korneliuszo/picopocket-hw/(threads)

Thread 2 (2025-04-10):

Want to buy picopocket-hw (makers needed)

korneliuszo, 2025-04-10:
> Thanks @HeathenUK!
>
> Btw, do you have any plans to sell assembled units?

 _Originally posted by @rafael2k in [#1](https://github.com/korneliuszo/picopocket-hw/issues/1#issuecomment-2793152441)_

Sorry, I don't have means to produce this project.

If somebody is interested in setting up production I can send working prototype to help setting up QA station and work out manufacturing problems

rafael2k, 2025-04-11:
Thanks for the answer and availability to support production!
