korneliuszo/picopocket-hw/companionboard/companion_board.kicad_pcb

## KiCad design companionboard/companion_board.kicad_pcb (2025-04-15)

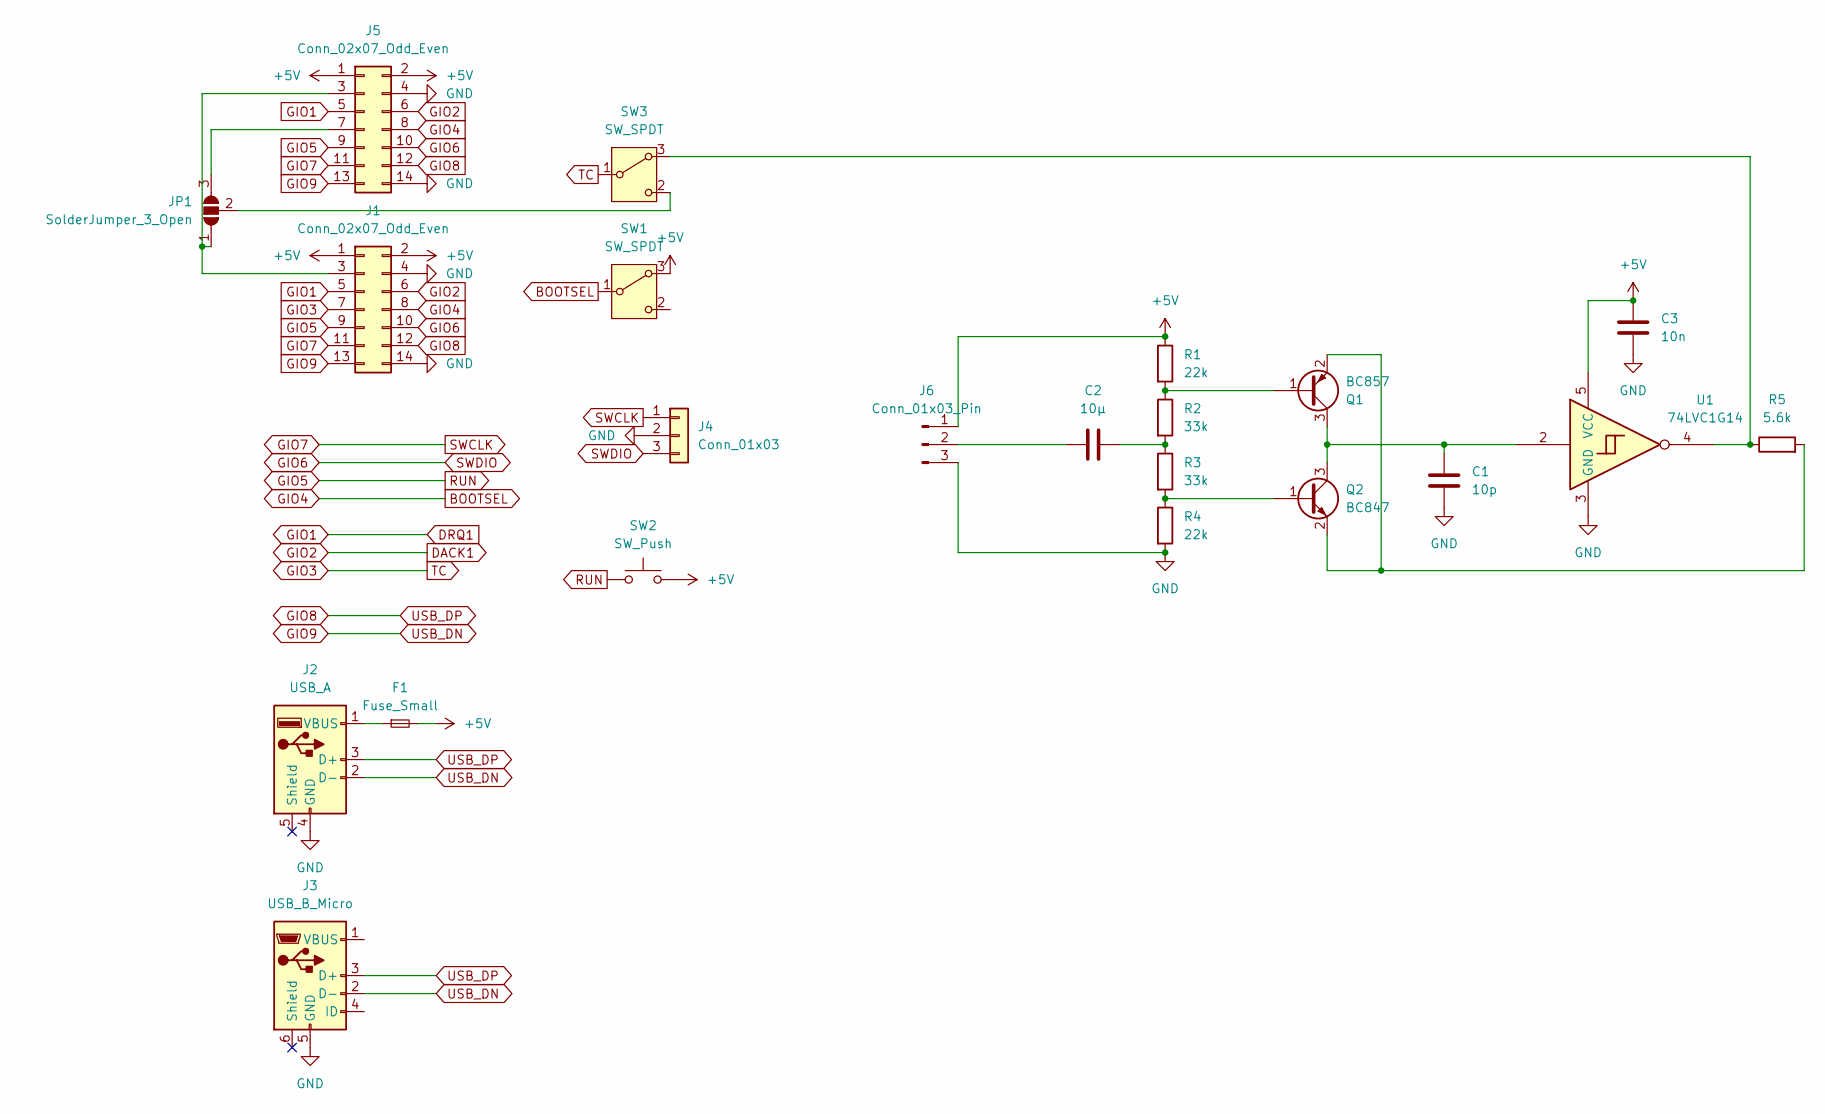
[picture p1: schematic companion_board.kicad_sch]

Parts:
C1: 10p; C_0805_2012Metric
C2: 10µ; C_0805_2012Metric
C3: 10n; C_0805_2012Metric
F1: Fuse_Small; Fuse_0805_2012Metric
J1: Conn_02x07_Odd_Even; EDGE-14
J2: USB_A; USB_A_CONNFLY_DS1095-WNR0
J3: USB_B_Micro; USB_Micro-B_Wuerth_614105150721_Vertical
J4: Conn_01x03; PinHeader_1x03_P2.54mm_Vertical
J5: Conn_02x07_Odd_Even; PinSocket_2x07_P2.00mm_Vertical
J6: Conn_01x03_Pin; PinHeader_1x03_P2.54mm_Vertical
JP1: SolderJumper_3_Open; SolderJumper-3_P2.0mm_Open_TrianglePad1.0x1.5mm
Q1: BC857; SOT-23
Q2: BC847; SOT-23
R1, R4: 22k; R_0402_1005Metric_Pad0.72x0.64mm_HandSolder
R2, R3: 33k; R_0402_1005Metric_Pad0.72x0.64mm_HandSolder
R5: 5.6k; R_0402_1005Metric_Pad0.72x0.64mm_HandSolder
SW1, SW3: SW_SPDT; SW_Slide-03_Wuerth-WS-SLTV_10x2.5x6.4_P2.54mm
SW2: SW_Push; SW_PUSH_6mm
U1: 74LVC1G14; SOT-353_SC-70-5_Handsoldering

Connections:
+5V: C3.1, F1.2, J1.1, J1.2, J5.1, J5.2, J6.1, R1.1, SW1.3 (A), SW2.2, U1.5 (VCC)
BOOTSEL: J1.8, J5.8, SW1.1 (B)
DACK1: J1.6, J5.6
DRQ1: J1.5, J5.5
GIO3: J1.7, SW3.1 (B)
GIO5: J1.9, J5.9, SW2.1
GIO6: J1.10, J4.3, J5.10
GIO7: J1.11, J4.1, J5.11
GIO8: J1.12, J2.3 (D+), J3.3 (D+), J5.12
GIO9: J1.13, J2.2 (D-), J3.2 (D-), J5.13
GND: C1.2, C3.2, J1.4, J1.14, J2.4 (GND), J3.5 (GND), J4.2, J5.4, J5.14, J6.3, R4.2, U1.3 (GND)
unnamed: C2.2, R2.2, R3.1
unnamed: J1.3, J5.3, JP1.1 (A)
unnamed: F1.1, J2.1 (VBUS)
unnamed: J5.7, JP1.3 (B)
unnamed: C2.1, J6.2
unnamed: JP1.2 (C), SW3.2 (C)
unnamed: Q1.1 (B), R1.2, R2.1
unnamed: C1.1, Q1.3 (C), Q2.3 (C), U1.2
unnamed: Q1.2 (E), Q2.2 (E), R5.2
unnamed: Q2.1 (B), R3.2, R4.1
unnamed: R5.1, SW3.3 (A), U1.4

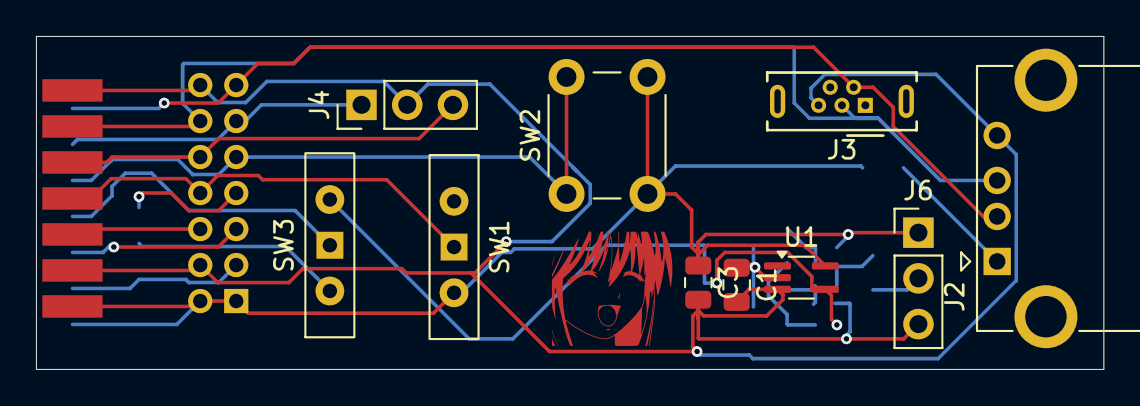
[picture p2: board companion_board.kicad_pcb from above]

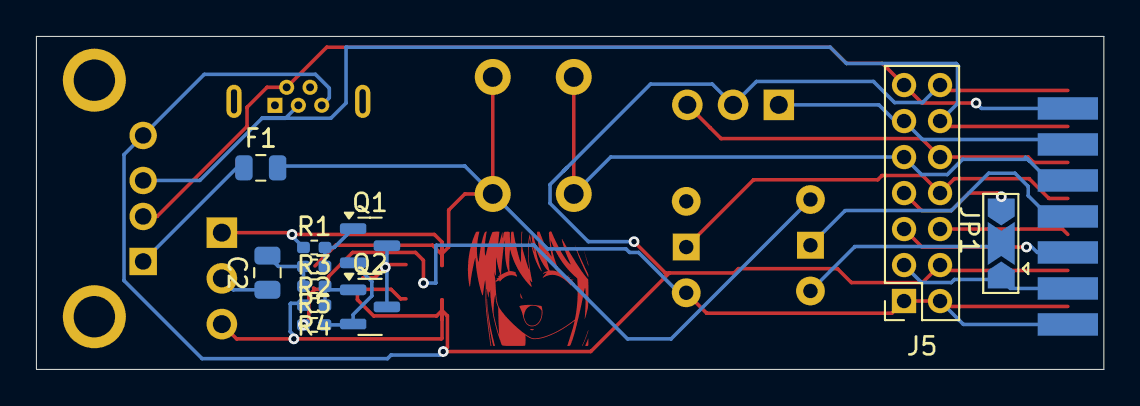
[picture p3: board companion_board.kicad_pcb from below]

Board: 2 copper layers, 59.3 x 18.5 mm, 22 parts (12 on the bottom side), 22 nets.
