korneliuszo/picopocket-hw/board/picopocket.kicad_pcb

## KiCad design board/picopocket.kicad_pcb (2024-04-07)

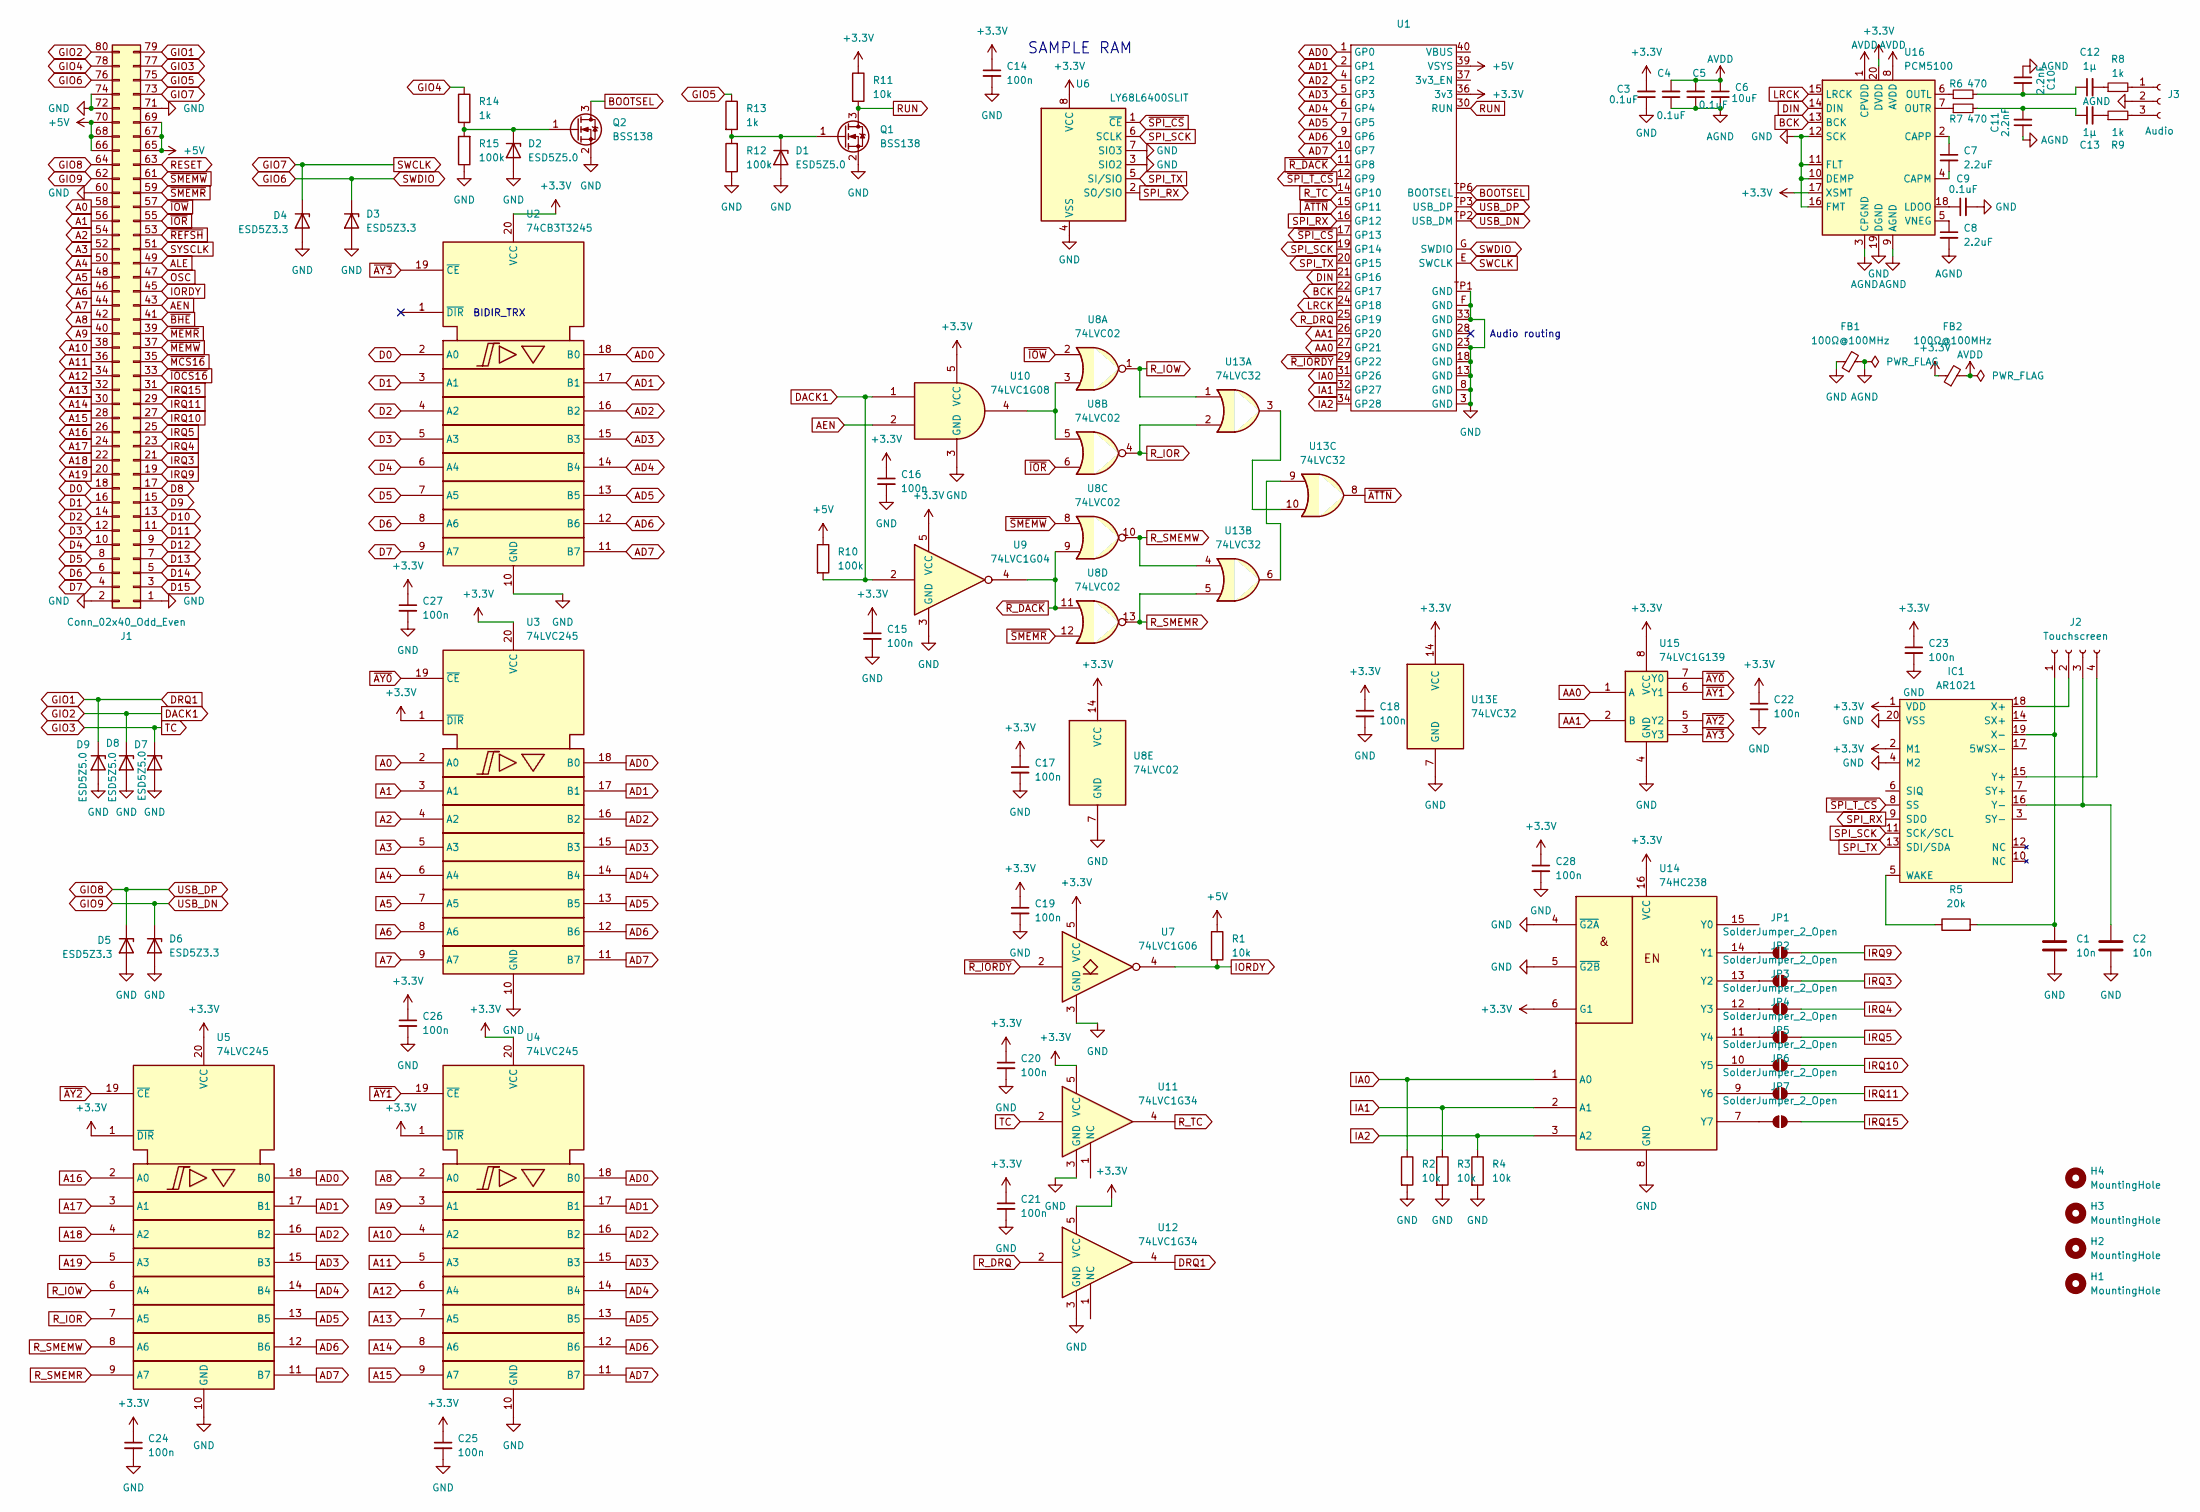
[picture p4: schematic picopocket.kicad_sch]

Parts:
C1, C2: 10n; C_0603_1608Metric; MPN C376807
C3, C4, C5, C9: 0.1uF; C_0402_1005Metric; MPN C361203
C6: 10uF; C_0805_2012Metric; MPN C1713
C7, C8: 2.2uF; C_0402_1005Metric; MPN C385032
C10, C11: 2.2nF; C_0603_1608Metric; MPN C107082
C12, C13: 1µ; C_1206_3216Metric; MPN C444884
C14, C15, C16, C17, C18, C19, C20, C21, C22, C23, C24, C25, C26, C27, C28: 100n; C_0201_0603Metric; MPN C5142565
D1, D2, D7, D8, D9: ESD5Z5.0; D_SOD-523; MPN C475685
D3, D4, D5, D6: ESD5Z3.3; D_SOD-523; MPN C475684
FB1, FB2: 100Ω@100MHz; L_0805_2012Metric; MPN C124102
H1, H2, H3, H4: MountingHole; MountingHole_2.7mm_M2.5_ISO14580_Pad
IC1: AR1021; SSOP-20_5.3x7.2mm_P0.65mm; MPN C220291; Farnell 2218568
J1: Conn_02x40_Odd_Even; XKB Male 80P 0.5P
J2: Touchscreen; Molex_PicoBlade_53261-0471_1x04-1MP_P1.25mm_Horizontal
J3: Audio; Molex_PicoBlade_53261-0371_1x03-1MP_P1.25mm_Horizontal
JP1, JP2, JP3, JP4, JP5, JP6, JP7: SolderJumper_2_Open; SolderJumper-2_P1.3mm_Open_TrianglePad1.0x1.5mm
Q1, Q2: BSS138; SOT-23; MPN C5337205
R1, R2, R3, R4, R11: 10k; R_0402_1005Metric; MPN C163811
R5: 20k; R_0402_1005Metric; MPN C3017501
R6, R7: 470; R_0402_1005Metric; MPN C3015779
R8, R9, R13, R14: 1k; R_0402_1005Metric; MPN C3152105
R10, R12, R15: 100k; R_0402_1005Metric; MPN C176119
U1: MODULE_SC0918
U2: 74CB3T3245; TSSOP-20_4.4x6.5mm_P0.65mm; MPN C1547227
U3, U4, U5: 74LVC245; TSSOP-20_4.4x6.5mm_P0.65mm; MPN C6082
U6: LY68L6400SLIT; SOIC-8_3.9x4.9mm_P1.27mm; MPN C261881
U7: 74LVC1G06; SOT-23-5; MPN C840103
U8: 74LVC02; TSSOP-14_4.4x5mm_P0.65mm; MPN C75069
U9: 74LVC1G04; SOT-23-5; MPN C460517
U10: 74LVC1G08; SOT-23-5; MPN C434068
U11, U12: 74LVC1G34; SOT-23-5; MPN C840096
U13: 74LVC32; TSSOP-14_4.4x5mm_P0.65mm; MPN C352974
U14: 74HC238; TSSOP-16_4.4x5mm_P0.65mm; MPN C60434
U15: 74LVC1G139; VSSOP-8_2.4x2.1mm_P0.5mm; MPN C153798
U16: PCM5100; TSSOP-20_4.4x6.5mm_P0.65mm; MPN C131154

Connections:
+3.3V: C3.2, C14.1, C15.1, C16.1, C17.1, C18.1, C19.1, C20.1, C21.1, C22.1, C23.1, C24.1, C25.1, C26.1, C27.1, C28.1, FB2.1, IC1.1 (VDD), IC1.2 (M1), R11.1, U1.36 (3v3), U2.20 (VCC), U3.1 (~DIR), U3.20 (VCC), U4.1 (~DIR), U4.20 (VCC), U5.1 (~DIR), U5.20 (VCC), U6.8 (VCC), U7.5 (VCC), U8.14 (VCC), U9.5 (VCC), U10.5 (VCC), U11.5 (VCC), U12.5 (VCC), U13.14 (VCC), U14.6 (G1), U14.16 (VCC), U15.8 (VCC), U16.17 (XSMT), U16.20 (DVDD)
+5V: J1.65, J1.66, J1.67, J1.68, J1.69, J1.70, R1.1, R10.1, U1.39 (VSYS)
A0: J1.58, U3.2 (A0)
A1: J1.56, U3.3 (A1)
A2: J1.54, U3.4 (A2)
A3: J1.52, U3.5 (A3)
A4: J1.50, U3.6 (A4)
A5: J1.48, U3.7 (A5)
A6: J1.46, U3.8 (A6)
A7: J1.44, U3.9 (A7)
A8: J1.42, U4.2 (A0)
A9: J1.40, U4.3 (A1)
A10: J1.38, U4.4 (A2)
A11: J1.36, U4.5 (A3)
A12: J1.34, U4.6 (A4)
A13: J1.32, U4.7 (A5)
A14: J1.30, U4.8 (A6)
A15: J1.28, U4.9 (A7)
A16: J1.26, U5.2 (A0)
A17: J1.24, U5.3 (A1)
A18: J1.22, U5.4 (A2)
A19: J1.20, U5.5 (A3)
AA0: U1.27 (GP21), U15.1 (A)
AA1: U1.26 (GP20), U15.2 (B)
AD0: U1.1 (GP0), U2.18 (B0), U3.18 (B0), U4.18 (B0), U5.18 (B0)
AD1: U1.2 (GP1), U2.17 (B1), U3.17 (B1), U4.17 (B1), U5.17 (B1)
AD2: U1.4 (GP2), U2.16 (B2), U3.16 (B2), U4.16 (B2), U5.16 (B2)
AD3: U1.5 (GP3), U2.15 (B3), U3.15 (B3), U4.15 (B3), U5.15 (B3)
AD4: U1.6 (GP4), U2.14 (B4), U3.14 (B4), U4.14 (B4), U5.14 (B4)
AD5: U1.7 (GP5), U2.13 (B5), U3.13 (B5), U4.13 (B5), U5.13 (B5)
AD6: U1.9 (GP6), U2.12 (B6), U3.12 (B6), U4.12 (B6), U5.12 (B6)
AD7: U1.10 (GP7), U2.11 (B7), U3.11 (B7), U4.11 (B7), U5.11 (B7)
AEN: J1.43, U10.2
AGND: C4.1, C5.1, C6.2, C8.2, C10.1, C11.1, FB1.2, J3.2, U16.3 (CPGND), U16.9 (AGND)
ALE: J1.49
AVDD: C4.2, C5.2, C6.1, FB2.2, U16.1 (CPVDD), U16.8 (AVDD)
BCK: U1.22 (GP17), U16.13 (BCK)
BOOTSEL: Q2.3 (D), U1.TP6 (BOOTSEL)
D0: J1.18, U2.2 (A0)
D1: J1.16, U2.3 (A1)
D2: J1.14, U2.4 (A2)
D3: J1.12, U2.5 (A3)
D4: J1.10, U2.6 (A4)
D5: J1.8, U2.7 (A5)
D6: J1.6, U2.8 (A6)
D7: J1.4, U2.9 (A7)
D8: J1.17
D9: J1.15
D10: J1.13
D11: J1.11
D12: J1.9
D13: J1.7
D14: J1.5
D15: J1.3
DACK1: D8.1 (K), J1.80, R10.2, U9.2, U10.1
DIN: U1.21 (GP16), U16.14 (DIN)
DRQ1: D9.1 (K), J1.79, U12.4
GIO3: D7.1 (K), J1.77, U11.2
GIO4: J1.78, R14.1
GIO5: J1.75, R13.1
GIO6: D3.1 (K), J1.76, U1.G (SWDIO)
GIO7: D4.1 (K), J1.73, U1.E (SWCLK)
GIO8: D5.1 (K), J1.64, U1.TP3 (USB_DP)
GIO9: D6.1 (K), J1.62, U1.TP2 (USB_DM)
GND: C1.2, C2.2, C3.1, C9.2, C14.2, C15.2, C16.2, C17.2, C18.2, C19.2, C20.2, C21.2, C22.2, C23.2, C24.2, C25.2, C26.2, C27.2, C28.2, D1.2 (A), D2.2 (A), D3.2 (A), D4.2 (A), D5.2 (A), D6.2 (A), D7.2 (A), D8.2 (A), D9.2 (A), FB1.1, IC1.4 (M2), IC1.20 (VSS), J1.1, J1.2, J1.60, J1.71, J1.72, J1.74, Q1.2 (S), Q2.2 (S), R2.2, R3.2, R4.2, R12.1, R15.1, U1.3 (GND), U1.8 (GND), U1.13 (GND), U1.18 (GND), U1.23 (GND), U1.33 (GND), U1.F (GND), U1.TP1 (GND), U2.10 (GND), U3.10 (GND), U4.10 (GND), U5.10 (GND), U6.3 (SIO2), U6.4 (VSS), U6.7 (SIO3), U7.3 (GND), U8.7 (GND), U9.3 (GND), U10.3 (GND), U11.3 (GND), U12.3 (GND), U13.7 (GND), U14.4 (~G2A), U14.5 (~G2B), U14.8 (GND), U15.4 (GND), U16.10 (DEMP), U16.11 (FLT), U16.12 (SCK), U16.16 (FMT), U16.19 (DGND)
IA0: R2.1, U1.31 (GP26), U14.1 (A0)
IA1: R3.1, U1.32 (GP27), U14.2 (A1)
IA2: R4.1, U1.34 (GP28), U14.3 (A2)
IORDY: J1.45, R1.2, U7.4
IRQ3: J1.21, JP2.2 (B)
IRQ4: J1.23, JP3.2 (B)
IRQ5: J1.25, JP4.2 (B)
IRQ9: J1.19, JP1.2 (B)
IRQ10: J1.27, JP5.2 (B)
IRQ11: J1.29, JP6.2 (B)
IRQ15: J1.31, JP7.2 (B)
LRCK: U1.24 (GP18), U16.15 (LRCK)
unnamed: C10.2, C12.1, R6.2
unnamed: C11.2, C13.1, R7.2
unnamed: C12.2, R8.1
unnamed: C13.2, R9.1
unnamed: D1.1 (K), Q1.1 (G), R12.2, R13.2
unnamed: D2.1 (K), Q2.1 (G), R14.2, R15.2
unnamed: IC1.5 (WAKE), R5.1
unnamed: IC1.18 (X+), J2.2
unnamed: C1.1, IC1.19 (X-), J2.1, R5.2
unnamed: IC1.15 (Y+), J2.4
unnamed: C2.1, IC1.16 (Y-), J2.3
unnamed: J3.1, R8.2
unnamed: J3.3, R9.2
unnamed: JP1.1 (A), U14.14 (Y1)
unnamed: JP2.1 (A), U14.13 (Y2)
unnamed: JP3.1 (A), U14.12 (Y3)
unnamed: JP4.1 (A), U14.11 (Y4)
unnamed: JP5.1 (A), U14.10 (Y5)
unnamed: JP6.1 (A), U14.9 (Y6)
unnamed: JP7.1 (A), U14.7 (Y7)
unnamed: U8.3, U8.5, U10.4
unnamed: U13.6, U13.9
unnamed: U13.3, U13.10
unnamed: C7.2, U16.4 (CAPM)
unnamed: C7.1, U16.2 (CAPP)
unnamed: C9.1, U16.18 (LDOO)
unnamed: R6.1, U16.6 (OUTL)
unnamed: R7.1, U16.7 (OUTR)
unnamed: C8.1, U16.5 (VNEG)
OSC: J1.47
RESET: J1.63
RUN: Q1.3 (D), R11.2, U1.30 (RUN)
R_DRQ: U1.25 (GP19), U12.2
R_IOR: U5.7 (A5), U8.4, U13.2
R_IOW: U5.6 (A4), U8.1, U13.1
R_SMEMR: U5.9 (A7), U8.13, U13.5
R_SMEMW: U5.8 (A6), U8.10, U13.4
R_TC: U1.14 (GP10), U11.4
SPI_RX: IC1.9 (SDO), U1.16 (GP12), U6.2 (SO/SIO)
SPI_SCK: IC1.11 (SCK/SCL), U1.19 (GP14), U6.6 (SCLK)
SPI_TX: IC1.13 (SDI/SDA), U1.20 (GP15), U6.5 (SI/SIO)
SYSCLK: J1.51
~ATTN: U1.15 (GP11), U13.8
~AY0: U3.19 (~CE), U15.7 (Y0)
~AY1: U4.19 (~CE), U15.6 (Y1)
~AY2: U5.19 (~CE), U15.5 (Y2)
~AY3: U2.19 (~CE), U15.3 (Y3)
~BHE: J1.41
~IOCS16: J1.33
~IOR: J1.55, U8.6
~IOW: J1.57, U8.2
~MCS16: J1.35
~MEMR: J1.39
~MEMW: J1.37
~REFSH: J1.53
~R_DACK: U1.11 (GP8), U8.9, U8.11, U9.4
~R_IORDY: U1.29 (GP22), U7.2
~SMEMR: J1.59, U8.12
~SMEMW: J1.61, U8.8
~SPI_CS: U1.17 (GP13), U6.1 (~CE)
~SPI_T_CS: IC1.8 (SS), U1.12 (GP9)

Notes on the sheet:
Audio routing
SAMPLE RAM
BIDIR_TRX

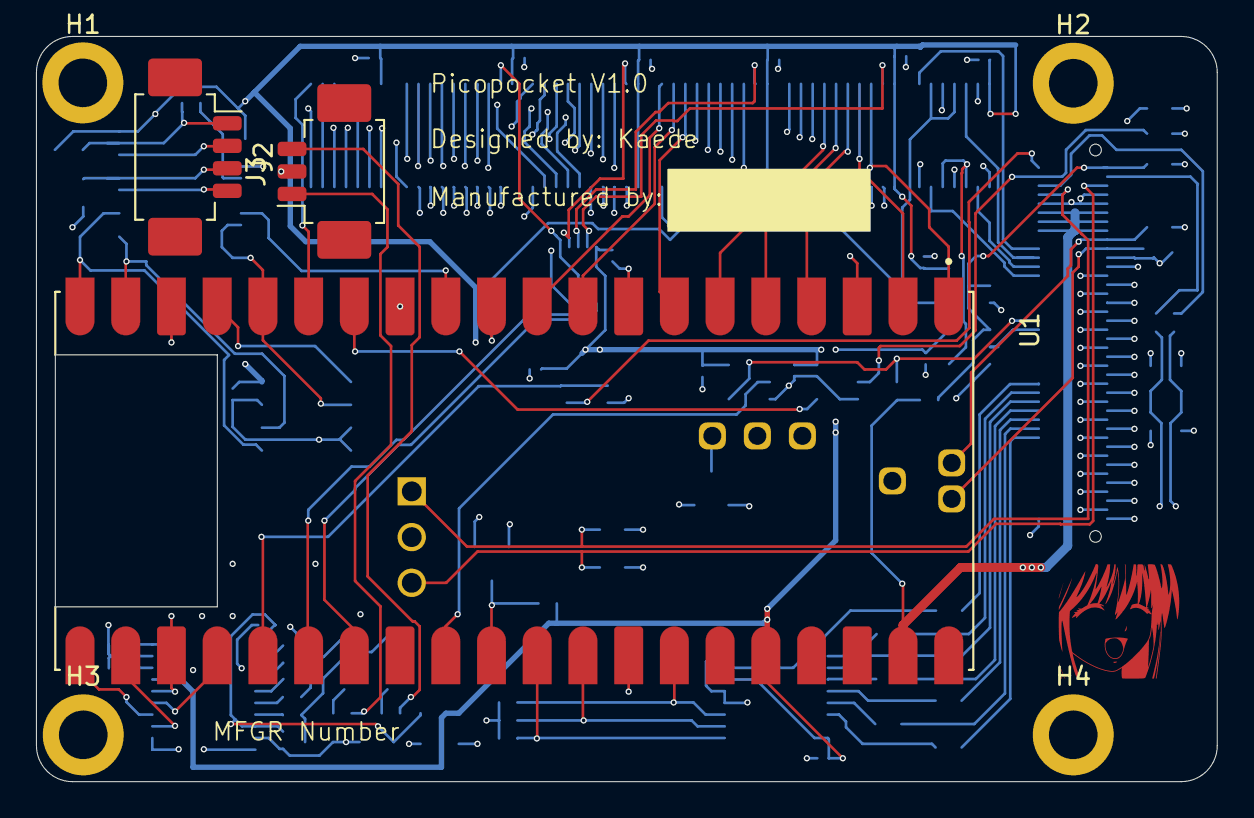
[picture p5: board picopocket.kicad_pcb from above]

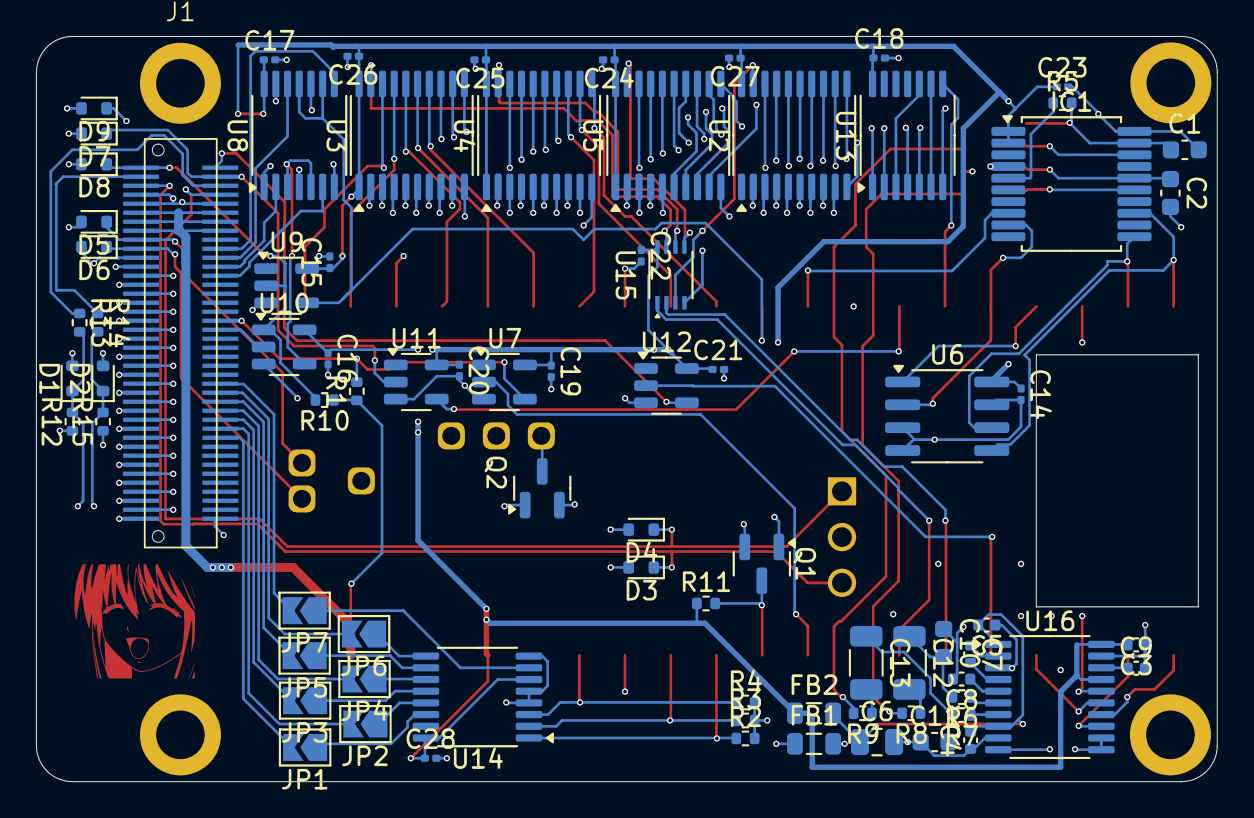
[picture p6: board picopocket.kicad_pcb from below]

Board: 4 copper layers, 65.6 x 41.4 mm, 87 parts (80 on the bottom side), 120 nets.
