korneliuszo/picopocket-hw/hw_lib/isa_worker.cpp

/*
 * SPDX-FileCopyrightText: Korneliusz Osmenda <korneliuszo@gmail.com>
 *
 * SPDX-License-Identifier: MIT
 */

#include "hardware/structs/sio.h"
#include "hardware/pio.h"
#include "hardware/gpio.h"
#include "hardware/dma.h"
#include "pico/multicore.h"
#include <array>
#include <cstring>
#include "hardware/clocks.h"
#include "hardware/structs/clocks.h"
#include "hardware/interp.h"
#include "hardware/sync.h"

#include "isa_dma.pio.h"

uint dma_helper_rd_offset;
uint dma_helper_wr_offset;

#include <isa_worker.hpp>

constexpr uint isa_bus_sm = 0;            // Warning : HardCoded ISA State Machine number for speed

constexpr uint TC_PIN = 10;
constexpr uint IA0_PIN = 26;

[[gnu::section(".core1")]] volatile uint8_t mem_map[1024*1024/2048]; //2kB resolution - bitfield
[[gnu::section(".core1")]] volatile uint8_t io_map[64*1024/8]; //8 IO regs resolution

volatile bool dma_single_transfer;

critical_section_t IRQ_setter;

[[gnu::constructor]]
void init_iordy()
{
	gpio_init(PIN_RDY);
	gpio_put(PIN_RDY, 1);
	gpio_set_dir(PIN_RDY,true);
}

void ISA_Pre_Init()
{
	// ************ Pico I/O Pin Initialisation ****************
	// * Put the I/O in a correct state to avoid PC Crash      *

	gpio_init(PIN_DRQ);
	gpio_put(PIN_DRQ, 0);
	gpio_set_dir(PIN_DRQ,true);

	//IRQ
	for(uint pin=IA0_PIN;pin<IA0_PIN+3;pin++)
	{
		gpio_init(pin);
		gpio_put(pin, 0);
		gpio_set_dir(pin,true);
	}

	memset((void*)mem_map,0,sizeof(mem_map));
	memset((void*)io_map,0,sizeof(io_map));
	critical_section_init(&IRQ_setter);
}

volatile bool TC_triggered_val;

static void TC_trigger_IRQ(void)
{
    if (gpio_get_irq_event_mask(TC_PIN)) {
       gpio_acknowledge_irq(TC_PIN, GPIO_IRQ_EDGE_RISE);
       TC_triggered_val = true;
    }
}

bool TC_Triggered()
{
	if(TC_triggered_val)
	{
		TC_triggered_val = false;
		return true;
	}
	return false;
}

void SetupSingleTransferTXDMA(uint dma_chan, const volatile uint8_t * buff, size_t len)
{
	initialize_dma_rd_pio(pio0);
    dma_channel_config c = dma_channel_get_default_config(dma_chan);
    channel_config_set_read_increment(&c, true);
    channel_config_set_write_increment(&c, false);
    channel_config_set_dreq(&c, pio_get_dreq(pio0, 1, true));
    channel_config_set_transfer_data_size(&c, DMA_SIZE_8);

    dma_channel_configure(dma_chan, &c,
    	&pio0->txf[1],      // Destination pointer
		buff,               // Source pointer
        len,                // Number of transfers
        true                // Start immediately
    );

    dma_single_transfer = true;
	TC_triggered_val = false;
}

void SetupSingleTransferRXDMA(uint dma_chan, volatile uint8_t * buff, size_t len)
{
	initialize_dma_wr_pio(pio0);
    dma_channel_config c = dma_channel_get_default_config(dma_chan);
    channel_config_set_read_increment(&c, false);
    channel_config_set_write_increment(&c, true);
    channel_config_set_dreq(&c, pio_get_dreq(pio0, 1, false));
    channel_config_set_transfer_data_size(&c, DMA_SIZE_8);

    dma_channel_configure(dma_chan, &c,
    	buff,               // Destination pointer
		&pio0->rxf[1],      // Source pointer
        len,                // Number of transfers
        true                // Start immediately
    );

    dma_single_transfer = true;
	TC_triggered_val = false;
}

bool DMA_Complete(uint dma_chan)
{
	return !dma_channel_is_busy(dma_chan);
}

void DMA_RX_Setup()
{
	initialize_dma_wr_pio(pio0);
}

void DMA_TX_Setup()
{
	initialize_dma_rd_pio(pio0);
}

bool __not_in_flash_func(DMA_RX_is_ready)()
{
	return ! pio_sm_is_rx_fifo_empty(pio0,1);
}

uint __not_in_flash_func(DMA_RX_ready_data)()
{
	return pio_sm_get_rx_fifo_level(pio0,1);
}

uint8_t __not_in_flash_func(DMA_RX_get)()
{
	return pio_sm_get(pio0,1);
}

void __not_in_flash_func(DMA_TX_put)(uint8_t val)
{
	pio_sm_put(pio0,1,val);
}

uint __not_in_flash_func(DMA_TX_ready_data)()
{
	return 8-pio_sm_get_tx_fifo_level(pio0,1);
}

void ISA_TC_Init()
{
	//TC line
	gpio_init(TC_PIN);
	gpio_set_irq_enabled(TC_PIN, GPIO_IRQ_EDGE_RISE, true);
	gpio_add_raw_irq_handler_masked((1<<TC_PIN), TC_trigger_IRQ);
	irq_set_enabled(IO_IRQ_BANK0, true);
}

void ISA_Init()
{
	initialize_isa_pio(pio0);
}

struct Device_int
{
	uint32_t start;
	uint32_t (*rdfn)(void*, uint32_t);
	void (*wrfn)(void*, uint32_t,uint8_t);
	void * obj;
};


constexpr uint32_t MEM_RD = (1<<(20+3));
constexpr uint32_t MEM_WR = (1<<(20+2));
constexpr uint32_t IO_RD = (1<<(20+1));
constexpr uint32_t IO_WR = (1<<(20+0));


std::array<Device_int,10> devices_mem = {};
std::array<Device_int,10> devices_io = {};

std::atomic<bool> wait_for_flash;

size_t used_devices_mem = 0;
size_t used_devices_io = 0;

bool add_device(const Device & device)
{
	switch(device.type)
	{
	case Device::Type::MEM:
		if(used_devices_mem == devices_mem.size())
			return false;
		{
			devices_mem[used_devices_mem] =
			{
					.start = device.start,
					.rdfn = device.rdfn,
					.wrfn = device.wrfn,
					.obj = device.obj,
			};
			for(uint32_t page=device.start;page<device.start+device.size;page+=2048)
			{
				uint32_t idx = page>>11;
				mem_map[idx]= 1+used_devices_mem;
			}
		}
		used_devices_mem++;
		break;
	case Device::Type::IO:
		if(used_devices_io == devices_io.size())
			return false;
		{
			devices_io[used_devices_io] =
			{
					.start = device.start,
					.rdfn = device.rdfn,
					.wrfn = device.wrfn,
					.obj = device.obj,
			};
			for(uint32_t page=device.start;page<device.start+device.size;page+=8)
			{
				uint32_t idx = page>>3;
				io_map[idx] = 1+used_devices_io;
			}
		}
		used_devices_io++;

		break;
	default:
		return false;
	}
	return true;
}


template <uint32_t OP, auto & device_tbl, uint32_t MASK>
[[gnu::always_inline]] static inline void do_transfer(const uint32_t idx, const uint32_t &ISA_TRANS)
{
	PIO isa_pio = pio0;
	uint32_t FADDR = ISA_TRANS & MASK;
	auto && dev = device_tbl[idx-1];

	if(ISA_TRANS&OP)
	{ // READ
		uint32_t datard;
		while(wait_for_flash);
		datard = dev.rdfn(dev.obj,FADDR - (dev.start));
		if(datard&ISA_FAKE_READ)
		{
			pio_sm_put(isa_pio,0,1);
		}
		else
		{
			pio_sm_put(isa_pio,0,2);
			pio_sm_put(isa_pio,0,datard);
		}
		return;
	}
	else
	{
		pio_sm_put(isa_pio,0,1);
		uint8_t data = gpio_get_all()>>PIN_AD0;
		while(wait_for_flash);
		dev.wrfn(dev.obj,FADDR - (dev.start),data);
		return;
	}

}


static void __scratch_x("core1_code") [[gnu::noreturn]] main_core1(void)
{
    interp_config cfg0 = interp_default_config();
    interp_config_set_shift(&cfg0,3);
    interp_config_set_mask(&cfg0,8-3,15-3);
    interp_set_config(interp0,0,&cfg0);
    interp_config cfg1 = interp_default_config();
    interp_config_set_shift(&cfg1,3);
    interp_config_set_mask(&cfg1,0,7-3);
    interp_set_config(interp0,1,&cfg1);

    interp0->base[2] = (uint32_t)((void*)io_map);

    for (;;)
	{
		constexpr uint32_t Yreg = 2; //rd
		uint32_t TMP, TMP2, TMP3;
		uint32_t ISA_TRANS, ISA_IDX;

		PIO isa_pio = pio0;

		interp_hw_t* isa_sio = interp0;

		uint32_t IORDY = (1u << (PIO_FSTAT_RXEMPTY_LSB + 0));
		uint32_t MEM_ACC = (3u << 22);


		// ** Wait until a Control signal is detected **
		asm volatile goto (
				"ldr %[TMP2], =%[Yreg] \n\t"
				"str     %[TMP2],[%[PIOB],%[PIOT]] \n\t" // pio->txf[0] = Yreg - turn on RDY
				"not_us_retry:\n\t"
				"1:\n\t"
				"ldr %[TMP], [%[PIOB],%[PIOF]]\n\t" // read fstat
				"tst %[TMP], %[IORDY]\n\t"			// test flag
				"bne 1b\n\t"						// loop if empty

				"ldr  %[ISA_TRANS],[%[PIOB],%[PIOR]] \n\t" // read ISA_TRANSACTION from PIO

				"tst    %[ISA_TRANS], %[MEM_ACC]\n\t"
				"bne mem\n\t" 							// memory_access

				"io:\n\t"
				"str %[ISA_TRANS], [%[SIOB], %[SIO_ACC0]]\n\t"
				"nop\n\t"
				"nop\n\t"
				"ldr  %[TMP],[%[PIOB],%[PIOR]] \n\t" // read ISA_TRANSACTION from PIO
				"str %[TMP], [%[SIOB], %[SIO_ACC1]]\n\t"
				"ldr %[TMP2], [%[SIOB], %[SIO_PEEK2]]\n\t"
				"ldrb %[ISA_IDX],[%[TMP2]]\n\t"	// tmp = io_map[tmp]

				"strb    %[ISA_IDX],[%[PIOB],%[PIOT]] \n\t" // pio->txf[0] = pin status;

				"cmp %[ISA_IDX], #0\n\t"
				"beq not_us_retry \n\t"
				"orr  %[ISA_TRANS], %[ISA_TRANS], %[TMP]\n\t"
				"b %l[ioaction]\n\t"							  // jump to memaction

				"mem:\n\t"
				"lsl    %[TMP], %[ISA_TRANS], #(4+8)\n\t" // TMP = ISA_TRANS << 4 // eat up flags
				"lsr    %[TMP], %[TMP], #(32-20+11)\n\t" // TMP = TMP >> (32-20+11) // move so we have page address
				"ldr %[TMP2], =%[MEMT] \n\t"
				"ldrb %[ISA_IDX],[%[TMP2],%[TMP]]\n\t"	// tmp = io_map[tmp]
				"strb    %[ISA_IDX],[%[PIOB],%[PIOT]] \n\t" // pio->txf[0] = pin status;
				"ldr  %[TMP],[%[PIOB],%[PIOR]] \n\t" // read ISA_TRANSACTION from PIO
				"cmp %[ISA_IDX], #0\n\t"
				"beq not_us_retry\n\t"
				"orr  %[ISA_TRANS], %[ISA_TRANS], %[TMP]\n\t"
				"b %l[memaction]\n\t" // jump to memaction

				".ltorg\n\t"
				:
				 [ISA_TRANS]"=l" (ISA_TRANS),
				 [ISA_IDX]"=l" (ISA_IDX),
				 [TMP]"=l" (TMP),
				 [TMP2]"=l" (TMP2),
				 [IORDY]"+l" (IORDY),
				 [MEM_ACC]"+l" (MEM_ACC),
				 [PIOB]"+l"(isa_pio),
				 [SIOB]"+l"(isa_sio)
				:[PIOT]"i" (PIO_TXF0_OFFSET),
				 [PIOR]"i" (PIO_RXF0_OFFSET),
				 [MEMT]"i" (mem_map),
				 [IOT]"i" (io_map),
				 [Yreg]"i" (Yreg),
				 [PIOF]"i"(PIO_FSTAT_OFFSET),
				 [SIO_ACC0]"i"(&static_cast<interp_hw_t*>(0)->accum[0]),
				 [SIO_ACC1]"i"(&static_cast<interp_hw_t*>(0)->accum[1]),
				 [SIO_PEEK2]"i"(&static_cast<interp_hw_t*>(0)->peek[2])
				:"cc"
				:memaction,
				 ioaction
				  );            // Tell the compiler that flags are changed

		continue;

		memaction:
		do_transfer<MEM_RD,devices_mem,0xFFFFF>(ISA_IDX,ISA_TRANS);
		continue;

		ioaction:
		do_transfer<IO_RD,devices_io,0xFFFF>(ISA_IDX,ISA_TRANS);
		continue;
	}
}

void ISA_Start()
{
	multicore_launch_core1(main_core1);
}

struct IRQh {
	bool lit;
	uint8_t address;
};

static constexpr size_t IRQh_len = 10;

static volatile IRQh irqhandlers[IRQh_len];
static volatile size_t IRQh_used;

void IRQ_Handle_Change_IRQ(uint8_t irqh,uint8_t irq)
{
	switch(irq)
	{
	case 9:
		irqhandlers[irqh].address=1;
		break;
	case 3:
		irqhandlers[irqh].address=2;
		break;
	case 4:
		irqhandlers[irqh].address=3;
		break;
	case 5:
		irqhandlers[irqh].address=4;
		break;
	case 10:
		irqhandlers[irqh].address=5;
		break;
	case 11:
		irqhandlers[irqh].address=6;
		break;
	case 15:
		irqhandlers[irqh].address=7;
		break;
	default:
		irqhandlers[irqh].address=0;
		break;
	}
}


uint8_t IRQ_Create_Handle(uint8_t irq)
{
	if(IRQh_used >= IRQh_len)
		return 0xff;
	IRQ_Handle_Change_IRQ(IRQh_used,irq);
	return IRQh_used++;
}

void IRQ_Set(uint8_t irqh, bool val)
{
	if(irqh >= IRQh_used)
		return;
	critical_section_enter_blocking(&IRQ_setter);
	irqhandlers[irqh].lit = val;
	uint8_t orirq = 0;
	for(size_t i=0;i<IRQh_used;i++) // first handler prioritized
	{
		if(irqhandlers[i].lit)
		{
			orirq = irqhandlers[i].address;
			break;
		}
	}
	gpio_put_masked(7<<IA0_PIN,orirq<<IA0_PIN);
	critical_section_exit(&IRQ_setter);
}
