korneliuszo/picopocket-hw/(commit log)

2024-04-04 Version 1.0
    [picopocket.kicad_pcb, picopocket.kicad_sch]
2024-04-06 Fix AR1021 footprint
    [picopocket.kicad_pcb, picopocket.kicad_sch]
2024-04-06 Fix divets in connector
    [picopocket.kicad_pcb]
2024-04-06 Add companion board
    [companion_board.kicad_pcb, companion_board.kicad_sch]
2024-04-06 Change to 74HC238 (avalibility)
    [picopocket.kicad_pcb, picopocket.kicad_sch]
2024-04-06 Replace to correct mounting hole, reroute accordingly
    [picopocket.kicad_pcb, picopocket.kicad_sch]
2024-04-06 Lock layout
    [picopocket.kicad_pcb]
2024-04-06 Update footprint to match exactly one on serial card
    Thanks HeathenUK
    [picopocket.kicad_pcb]
2024-04-07 Add jlcpcb part numbers
    [picopocket.kicad_pcb, picopocket.kicad_sch]
2024-04-07 Add production files
    [bom.csv, designators.csv, positions.csv]
2024-04-07 Add companion board production files
2024-04-07 Some random save
    [companion_board.kicad_pcb]
2024-05-19 Fix DMA implementation
2024-05-19 Add DMA tests
2024-06-10 Silence ... to be enabled back by revert
    [testd.cpp]
2024-06-10 Revert "Silence ... to be enabled back by revert"
    This reverts commit 0d2a703af32f2540bf7970c9cecbca40dd3fed44.
    [testd.cpp]
2024-06-13 Move main board schematics around
    [bom.csv, designators.csv, picopocket.kicad_pcb, picopocket.kicad_sch, positions.csv]
2024-07-16 Short spi code so spi for wifi fits
    [ar1021.hpp]
2024-10-23 Fix DMA
2024-10-25 Slow down pico to 250MHz - still 16MHz ISA possible
2024-12-22 Fix races in irq setting from 2 cores
    [isa_worker.cpp]
2024-12-25 Allow providing other boards
2025-01-02 Wait in IOCHRDY for pico initialization
2025-01-19 Update companionboard with line in input
    [companion_board.kicad_pcb, companion_board.kicad_sch]
2025-01-20 Tidy up board
    [companion_board.kicad_pcb, companion_board.kicad_sch]
2025-01-26 PSRAM dma high priority
2025-01-26 Fix compatibility with clear pocket
    [isa_worker.cpp]
2025-01-26 Add tracer target
2025-02-15 proper default to picopocket board
2025-02-17 Add TX DMA helper functions
2025-02-18 Fix flipped connector
    [companion_board.kicad_pcb]
